bdcannon/RFID_Deadbolt_Opener/SolidWorks/CompleteServo.SLDASM

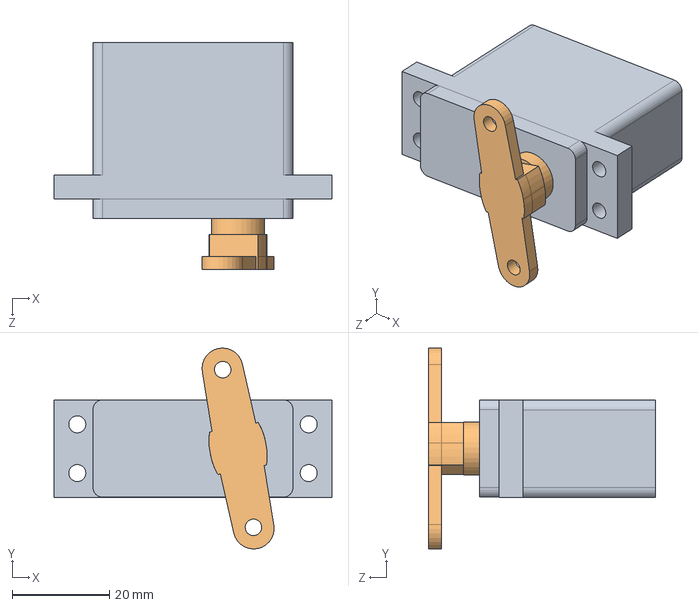
[picture p1: CAD file, 2013-08-10]
SolidWorks/CompleteServo.SLDASM
57.1 x 41.3 x 46.7 mm
ServoBody
ServoDoor
