bdcannon/RFID_Deadbolt_Opener/SolidWorks/Door Asembly.SLDASM

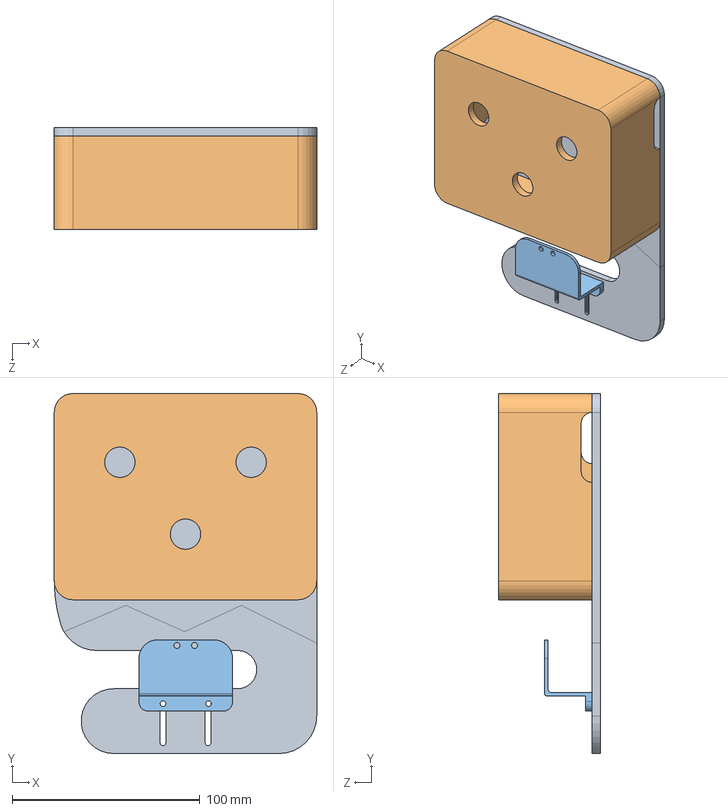
[picture p2: CAD file, 2013-08-10]
SolidWorks/Door Asembly.SLDASM
140.0 x 192.0 x 54.5 mm
Backdoorbracket
buttoncase
servoBracket
