bdcannon/RFID_Deadbolt_Opener/RFID_plate.stl

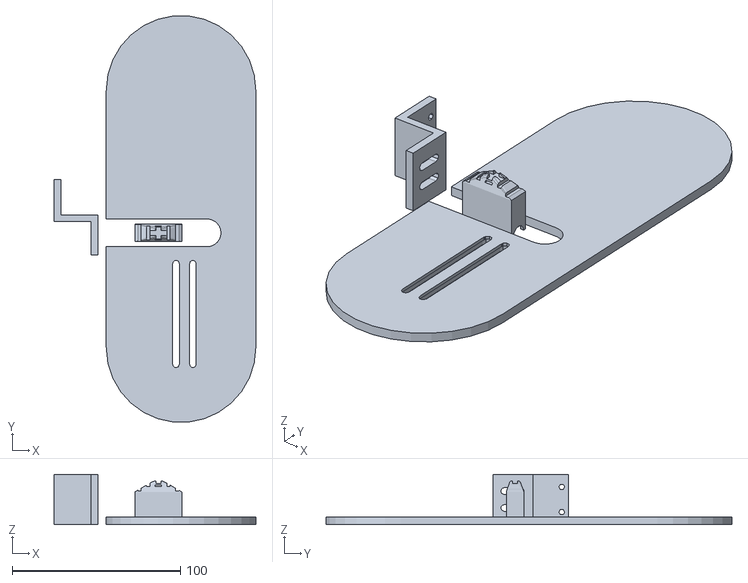
[picture p3: CAD file, 2013-08-04]
RFID_plate.stl
120.0 x 241.5 x 30.0
