bdcannon/RFID_Deadbolt_Opener/SolidWorks/buttoncase.SLDPRT

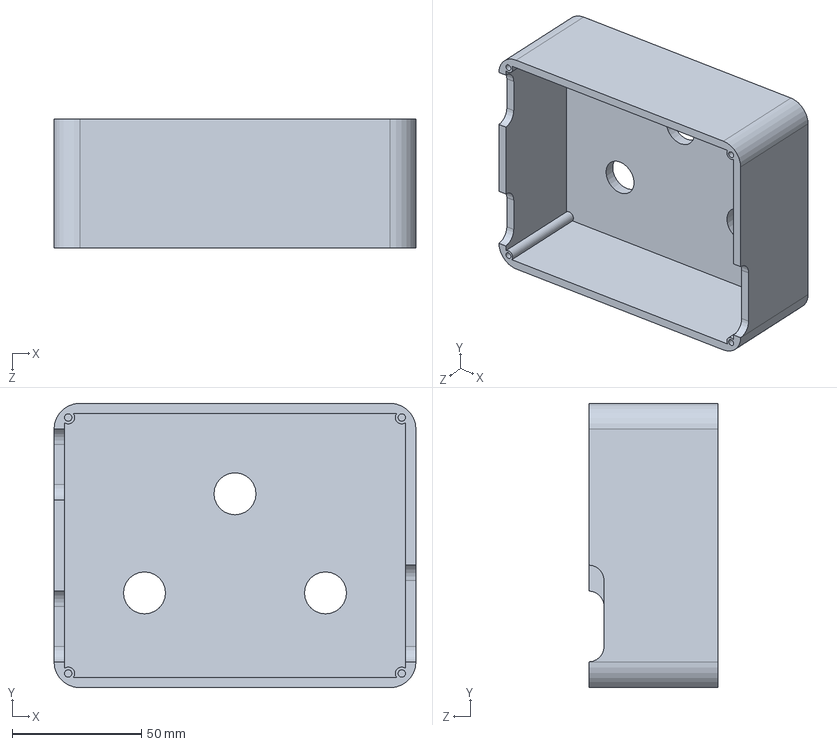
[picture p4: CAD file, 2013-08-10]
SolidWorks/buttoncase.SLDPRT
140.0 x 110.0 x 50.0 mm
