bdcannon/RFID_Deadbolt_Opener/SolidWorks/ThumbTurnCoupler.SLDPRT

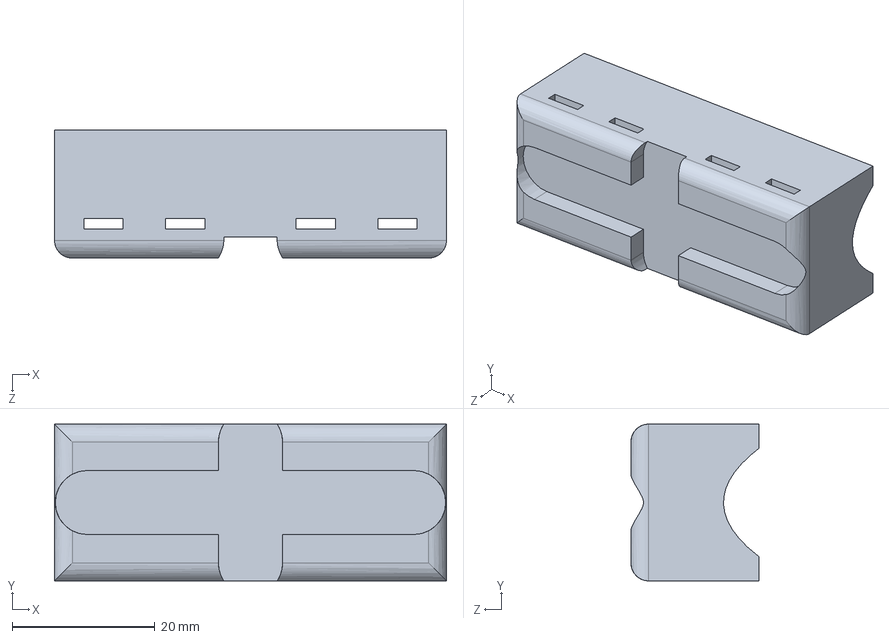
[picture p5: CAD file, 2013-08-10]
SolidWorks/ThumbTurnCoupler.SLDPRT
55.0 x 22.0 x 18.0 mm
