bdcannon/RFID_Deadbolt_Opener/SolidWorks/ServoHorn.SLDPRT

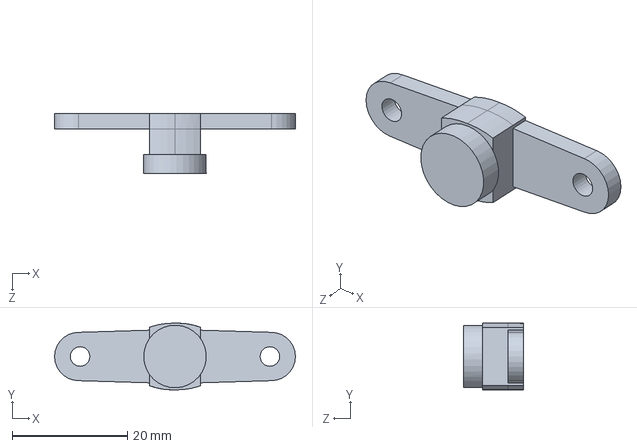
[picture p6: CAD file, 2013-08-10]
SolidWorks/ServoHorn.SLDPRT
41.9 x 11.6 x 10.5 mm
