bdcannon/RFID_Deadbolt_Opener/SolidWorks/servoBracket.SLDPRT

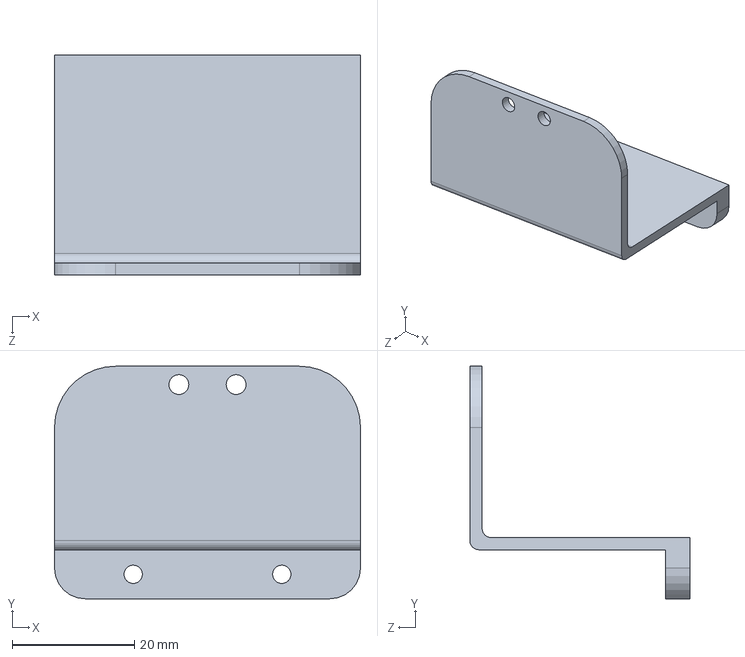
[picture p7: CAD file, 2013-08-10]
SolidWorks/servoBracket.SLDPRT
50.0 x 38.0 x 36.0 mm
