bdcannon/RFID_Deadbolt_Opener/SolidWorks/ServoBody.SLDPRT

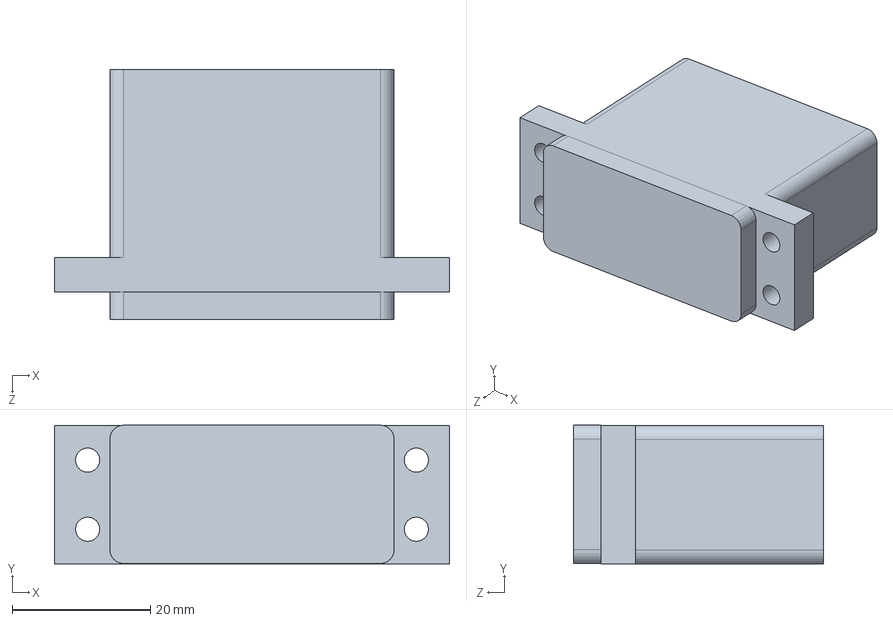
[picture p8: CAD file, 2013-08-10]
SolidWorks/ServoBody.SLDPRT
57.1 x 20.0 x 36.2 mm
