bdcannon/RFID_Deadbolt_Opener/SolidWorks/Backplate.SLDPRT

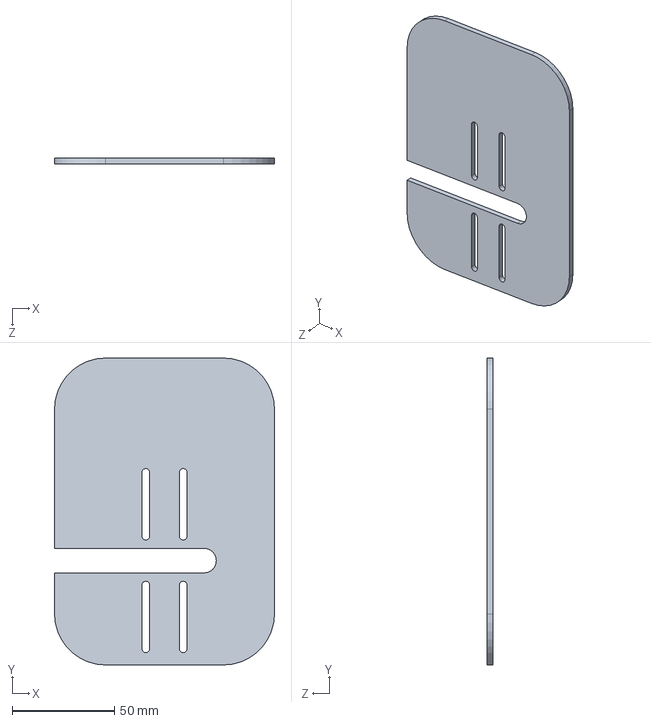
[picture p9: CAD file, 2013-08-10]
SolidWorks/Backplate.SLDPRT
107.5 x 150.0 x 3.00 mm
