bdcannon/RFID_Deadbolt_Opener/eagle/RFID1284/RFID1284.brd

## EAGLE design eagle/RFID1284/RFID1284.brd (2013-08-04)

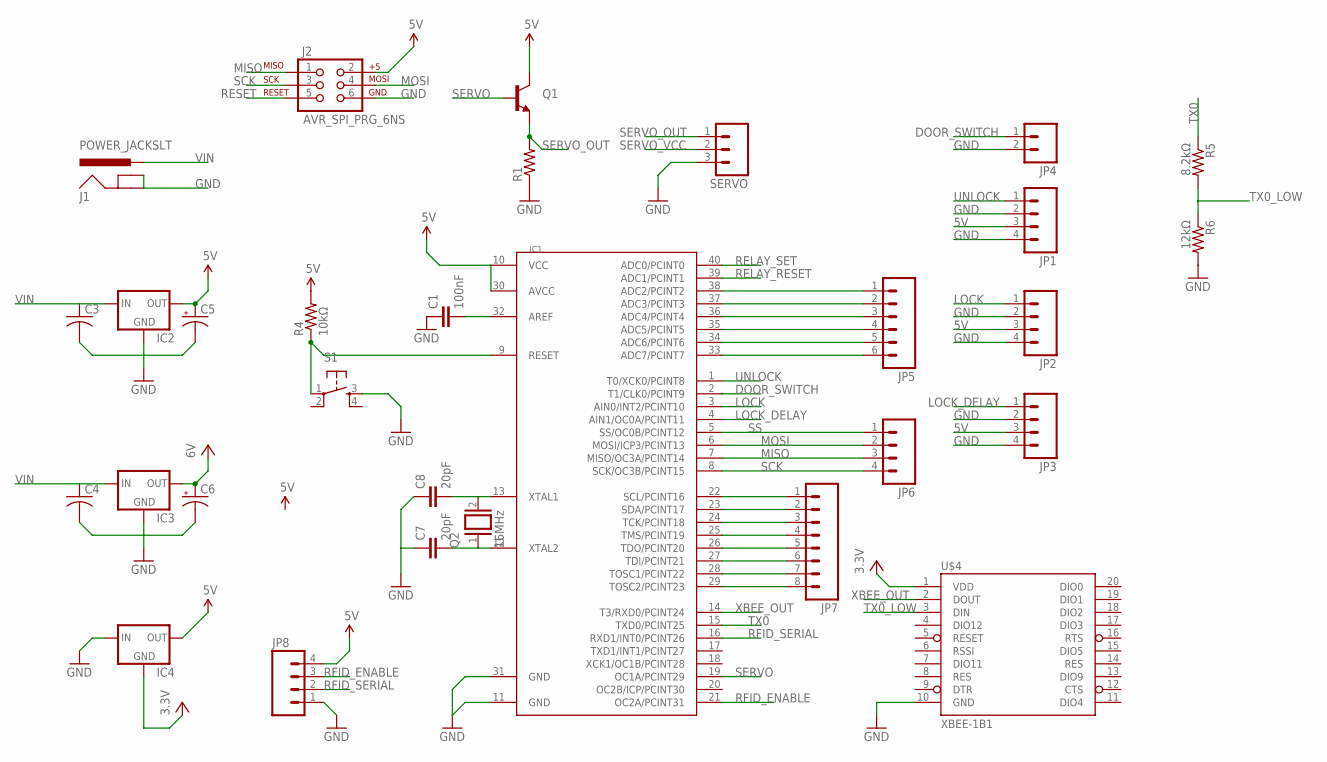
[picture p10: schematic RFID1284.sch]

Parts:
C1: 100nF; CAP-PTH-5MM
C3, C4: C-US025-040X050; C025-040X050
C5, C6: CPOL-USE2.5-7; E2,5-7
C7, C8: 20pF; CAP-PTH-5MM
IC1: MEGA1284P; DIL40
IC2, IC3, IC4: V_REG_78XXSINK; TO220-IGO
J1: POWER_JACKSLT; POWER_JACK_SLOT
J2: AVR_SPI_PRG_6NS; 2X3-NS
JP1, JP2, JP3, JP6: M04LOCK_LONGPADS; 1X04_LOCK_LONGPADS
JP4: M02LOCK_LONGPADS; 1X02_LOCK_LONGPADS
JP5: M06LOCK_LONGPADS; 1X06_LOCK_LONGPADS
JP7: M08LOCK_LONGPADS; 1X08_LOCK_LONGPADS
JP8: M04LONGPADS; 1X04_LONGPADS
Q1: TRANSISTOR_NPNTO-92-AMMO; TO-92-AMMO
Q2: 16MHz; QS
R1: RESISTORPTH-1/4W; AXIAL-0.4
R4: 10kΩ; AXIAL-0.4
R5: 8.2kΩ; AXIAL-0.4
R6: 12kΩ; AXIAL-0.4
S1: TAC_SWITCHPTH; TACTILE-PTH
SERVO: M03LONGPADS; 1X03_LONGPADS
U$4: XBEE-1B1; XBEE-1

Connections:
5V: C5.+, IC1.10 (VCC), IC1.30 (AVCC), IC2.OUT, IC4.OUT, J2.2, JP1.3, JP2.3, JP3.3, JP8.4, Q1.3 (C), R4.P$2 (2)
DOOR_SWITCH: IC1.2 (T1/CLK0/PCINT9), JP4.1
GND: C1.1, C3.2, C4.2, C5.-, C6.-, C7.1, C8.1, IC1.11 (GND), IC1.31 (GND), IC2.GND, IC3.GND, IC4.IN, J1.GND@1 (GNDBREAK), J1.GND@2 (GND), J2.6, JP1.2, JP1.4, JP2.2, JP2.4, JP3.2, JP3.4, JP4.2, JP8.1, R1.P$1 (1), R6.P$2 (2), S1.3, SERVO.3, U$4.10 (GND)
LOCK: IC1.3 (AIN0/INT2/PCINT10), JP2.1
LOCK_DELAY: IC1.4 (AIN1/OC0A/PCINT11), JP3.1
MISO: IC1.7 (MISO/OC3A/PCINT14), J2.1, JP6.3
MOSI: IC1.6 (MOSI/ICP3/PCINT13), J2.4, JP6.2
unnamed: C7.2, IC1.12 (XTAL2), Q2.1
unnamed: C1.2, IC1.32 (AREF)
unnamed: C8.2, IC1.13 (XTAL1), Q2.2
unnamed: IC1.38 (ADC2/PCINT2), JP5.1
unnamed: IC1.37 (ADC3/PCINT3), JP5.2
unnamed: IC1.36 (ADC4/PCINT4), JP5.3
unnamed: IC1.35 (ADC5/PCINT5), JP5.4
unnamed: IC1.34 (ADC6/PCINT6), JP5.5
unnamed: IC1.33 (ADC7/PCINT7), JP5.6
unnamed: IC1.22 (SCL/PCINT16), JP7.1
unnamed: IC1.23 (SDA/PCINT17), JP7.2
unnamed: IC1.24 (TCK/PCINT18), JP7.3
unnamed: IC1.25 (TMS/PCINT19), JP7.4
unnamed: IC1.26 (TDO/PCINT20), JP7.5
unnamed: IC1.27 (TDI/PCINT21), JP7.6
unnamed: IC1.28 (TOSC1/PCINT22), JP7.7
unnamed: IC1.29 (TOSC2/PCINT23), JP7.8
RELAY_RESET: IC1.39 (ADC1/PCINT1)
RELAY_SET: IC1.40 (ADC0/PCINT0)
RESET: IC1.9 (RESET), J2.5, R4.P$1 (1), S1.1
RFID_ENABLE: IC1.21 (OC2A/PCINT31), JP8.3
RFID_SERIAL: IC1.16 (RXD1/INT0/PCINT26), JP8.2
SCK: IC1.8 (SCK/OC3B/PCINT15), J2.3, JP6.4
SERVO: IC1.19 (OC1A/PCINT29), Q1.2 (B)
SERVO_OUT: Q1.1 (E), R1.P$2 (2), SERVO.1
SERVO_VCC: C6.+, IC3.OUT, SERVO.2
SS: IC1.5 (SS/OC0B/PCINT12), JP6.1
TX0: IC1.15 (TXD0/PCINT25), R5.P$1 (1)
TX0_LOW: R5.P$2 (2), R6.P$1 (1), U$4.3 (DIN)
UNLOCK: IC1.1 (T0/XCK0/PCINT8), JP1.1
VCC: IC4.GND, U$4.1 (VDD)
VIN: C3.1, C4.1, IC2.IN, IC3.IN, J1.PWR
XBEE_OUT: IC1.14 (T3/RXD0/PCINT24), U$4.2 (DOUT)

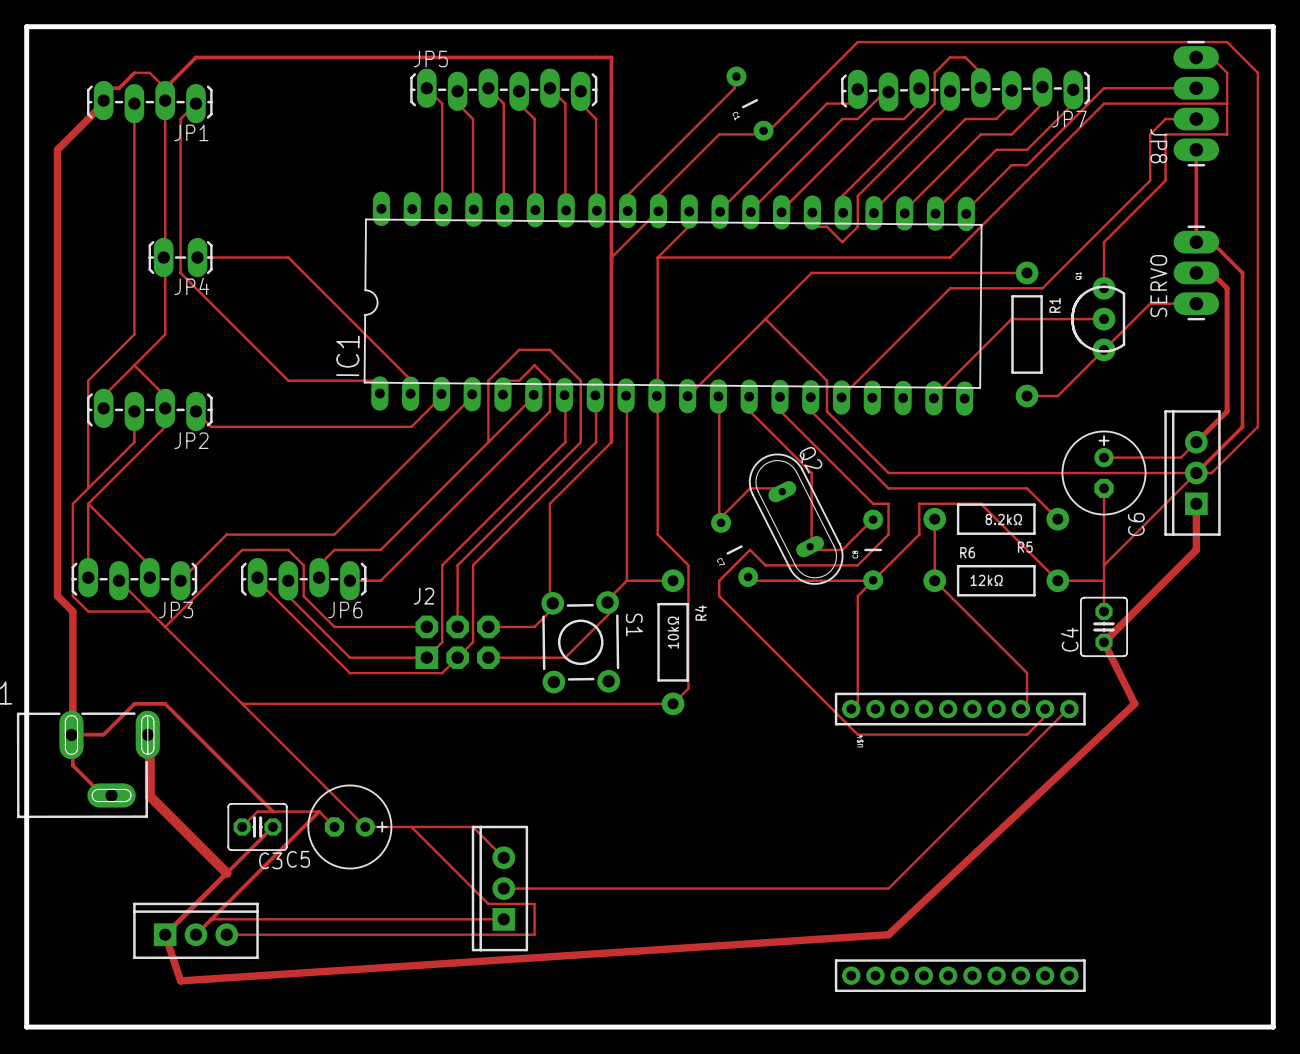
[picture p11: board RFID1284.brd from above]

Board: 2 copper layers, 102.9 x 82.5 mm, 30 parts (0 on the bottom side), 38 nets.
