bdcannon/RFID_Deadbolt_Opener/(commit log)

2012-12-25 Initial Commit
    Adds initial drawings of modules
    + backplate
    + servoBracket
    And utility module
    + slots
    Slots module needs to be moved to a utility file and initial offset of
    slots removed for ease of translation and rotation.
    [ServoDeadbolt.scad]
2012-12-25 Adds Changes to OpenSCAD Drawing
    Adds trap for slots in back plate and holes for servo mount to
    brackent.
    Notes: Bracket May need reinforcing
    [ServoDeadbolt.scad]
2012-12-26 Adds Coupling
    Adds Coupling
    [ServoDeadbolt.scad]
2012-12-26 Adds Plate Stl and Coupling
    Plate STL has not been test to work with real world deadbolts.
    Dead Bolt Coupling has a hack slot set up at the top for mounting a zip
    tie. May need to be revised.
    [RFID_plate.stl, ServoDeadbolt.scad]
2012-12-30 Adds Eagle Drawings for schmatic and PCB
    Adds Drawings for schematci and PCB for
    ATMega164A/PA/324A/PA/644A/PA/1284/P 40 Pin DIP package
    [RFID1284.brd, RFID1284.sch]
2012-12-30 Updates to Drawings
    Continued Work on Schematic and PCB
    [RFID1284.brd, RFID1284.sch]
2013-02-12 Kind of Done
    [RFID1284.sch, ServoDeadbolt.scad]
2013-08-04 Updates for most recent iteration
    This version of the source changes from the breadboard prototype to PCB
2013-08-10 Adds SolidWorks Drawings
    - Adds assemblies and drawings for equivalent to OpenSCAD version.
    [Backplate.SLDPRT, CompleteServo.SLDASM, Door Asembly.SLDASM, ServoBody.SLDPRT, ServoHorn.SLDPRT, ThumbTurnCoupler.SLDPRT, buttoncase.SLDPRT, servoBracket.SLDPRT]
